armaanhammer/411-practicum/README.md

# 411-practicum
Development for ECE 411 Fall 2017 Group 16 Practicum
