armaanhammer/411-practicum/Arduino Library used/README.md

# 411-practicum
Development for ECE 411 Fall 2017 Group 16 Practicum

In order for the code for the RealTime Clock (RTC) to compile, the RTC folder must be added to your Arduino libary.
