armaanhammer/411-practicum/Project Management/BOM_UV_MONITOR_V2_1.xlsx

Qty | Value | Device | Package | Parts | Description | Price (Digikey) | subtotal
1 | ST-TF-003A | MICRO-SD-CARD-SOCKET-9P(ST-TF-003A) | MICRO-SD9+4P-SMD-16.1X14.5X1.85MM | SD1 | MicroSD Card slot | 1.02 | 1.02
1 | 32.768kHz | CRYSTAL-32.768KHZSMD-2X6 | CRYSTAL-SMD-2X6-CYL | Y1 | 32.768kHz Crystal | 0.49 | 0.49
1 | 0.1uF +/-5% | C-EUC0805 | C0805 | C4 | CAPACITOR | 0.07 | 0.07
1 | 1nF +/-5% | C-EUC0805 | C0805 | C5 | CAPACITOR | 0.07 | 0.07
8 | 2.2nF +/-5% | C-EUC0805 | C0805 | C2 | CAPACITOR | 0.09 | 0.72
1 | 470pF +/-5% | C-EUC0805 | C0805 | C1 | CAPACITOR | 0.08 | 0.08
1 | ML8511 UV_SENSOR | ML8511 | ML8511 | U4 | Lapis ML8511 Ultraviolet Sensor | 6.76 | 6.76
1 | RGB_LED | LED-RGB-CASMD | LED-TRICOLOR-SMD | D1 | LED-RGB Diffused Common Anode | 0.34 | 0.34
1 | CR-AA | CR-AA | CRAA | 3V7_LI_BATT | LI BATTERY Varta | 5.95 | 5.95
1 | CR2032H | CR2032H | CR2032H | BATTERY | LI BATTERY Varta | 0.29 | 0.29
1 | 100k | R-US_R0805 | R0805 | R5 | RESISTOR | 0.02 | 0.02
4 | 10k | R-US_R0805 | R0805 | R1 | RESISTOR | 0.02 | 0.08
1 | 150k | R-US_R0805 | R0805 | R6 | RESISTOR | 0.02 | 0.02
1 | 2k | R-US_R0805 | R0805 | R4 | RESISTOR | 0.02 | 0.02
2 | 3k | R-US_R0805 | R0805 | R7 | RESISTOR | 0.02 | 0.04
1 | 80k | R-US_R0805 | R0805 | R3 | RESISTOR | 0.02 | 0.02
1 | MIC5219 3.3V | V_REG_MIC52193.3V | SOT23-5 | U9 | V_REG MIC5219 | 0.93 | 0.93
1 | 1V | DIODE-ZENER-BZT52C3V6S | SOD-323 | D2 | Zener Diode | 0.37 | 0.37
1 | ESP8266EX | ESP8266EX | ESP8266EX | U1 | Microproc | 1.75 | 1.75
1 | LM2903M | LM2903M | M08A | U2 | Opamp comp | 0.37 | 0.37
1 | MCP7940N-I/SN | MCP7940N-I/SN | SOIC8-N_MC | U3 | Real time clock | 0.78 | 0.78
1 | batt holder |  |  |  | Coin cell Holder and contact | 0.77 | 0.77
2 | batt holder |  |  |  | AA holder | 0.39 | 0.78
 |  |  |  |  |  |  | 21.74 | Total/board
