armaanhammer/411-practicum/Eagle/Schematics and Boards/UV_MONITOR_V3_0_board_bottom.pdf

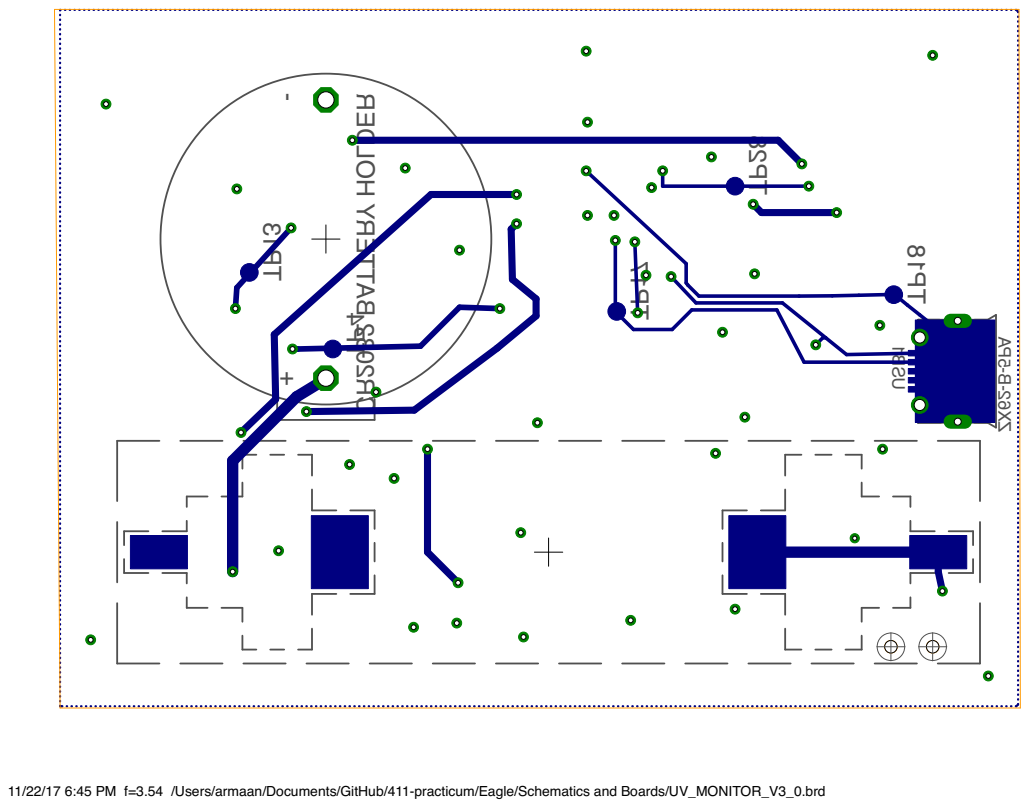
[picture p2: page 1]

11/22/17 6:45 PM f=3.54 /Users/armaan/Documents/GitHub/411-practicum/Eagle/Schematics and Boards/UV_MONITOR_V3_0.brd
