armaanhammer/411-practicum/Eagle/Schematics and Boards/UV_MONITOR_V3_0_board_top.pdf

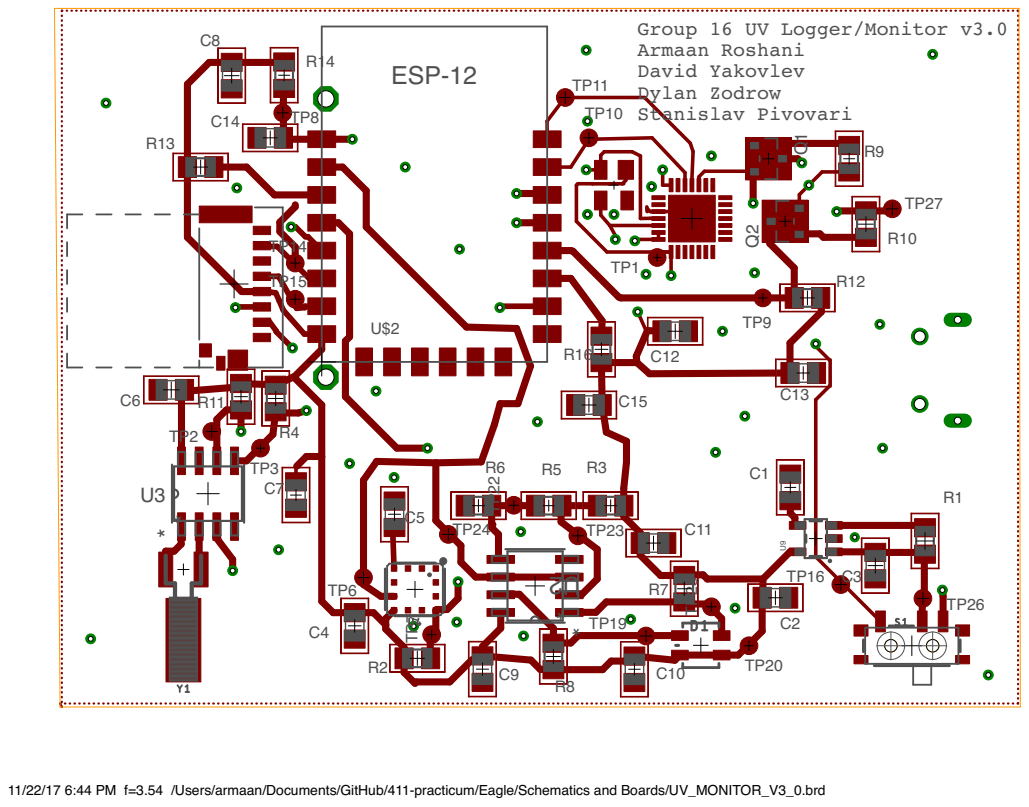
[picture p3: page 1]

Group 16 UV Logger/Monitor v3.0
Armaan Roshani
David Yakovlev
Dylan Zodrow
Stanislav Pivovari

11/22/17 6:44 PM f=3.54 /Users/armaan/Documents/GitHub/411-practicum/Eagle/Schematics and Boards/UV_MONITOR_V3_0.brd
