armaanhammer/411-practicum/Eagle/Schematics and Boards/UV_MONITOR_V3_0_schematic.pdf

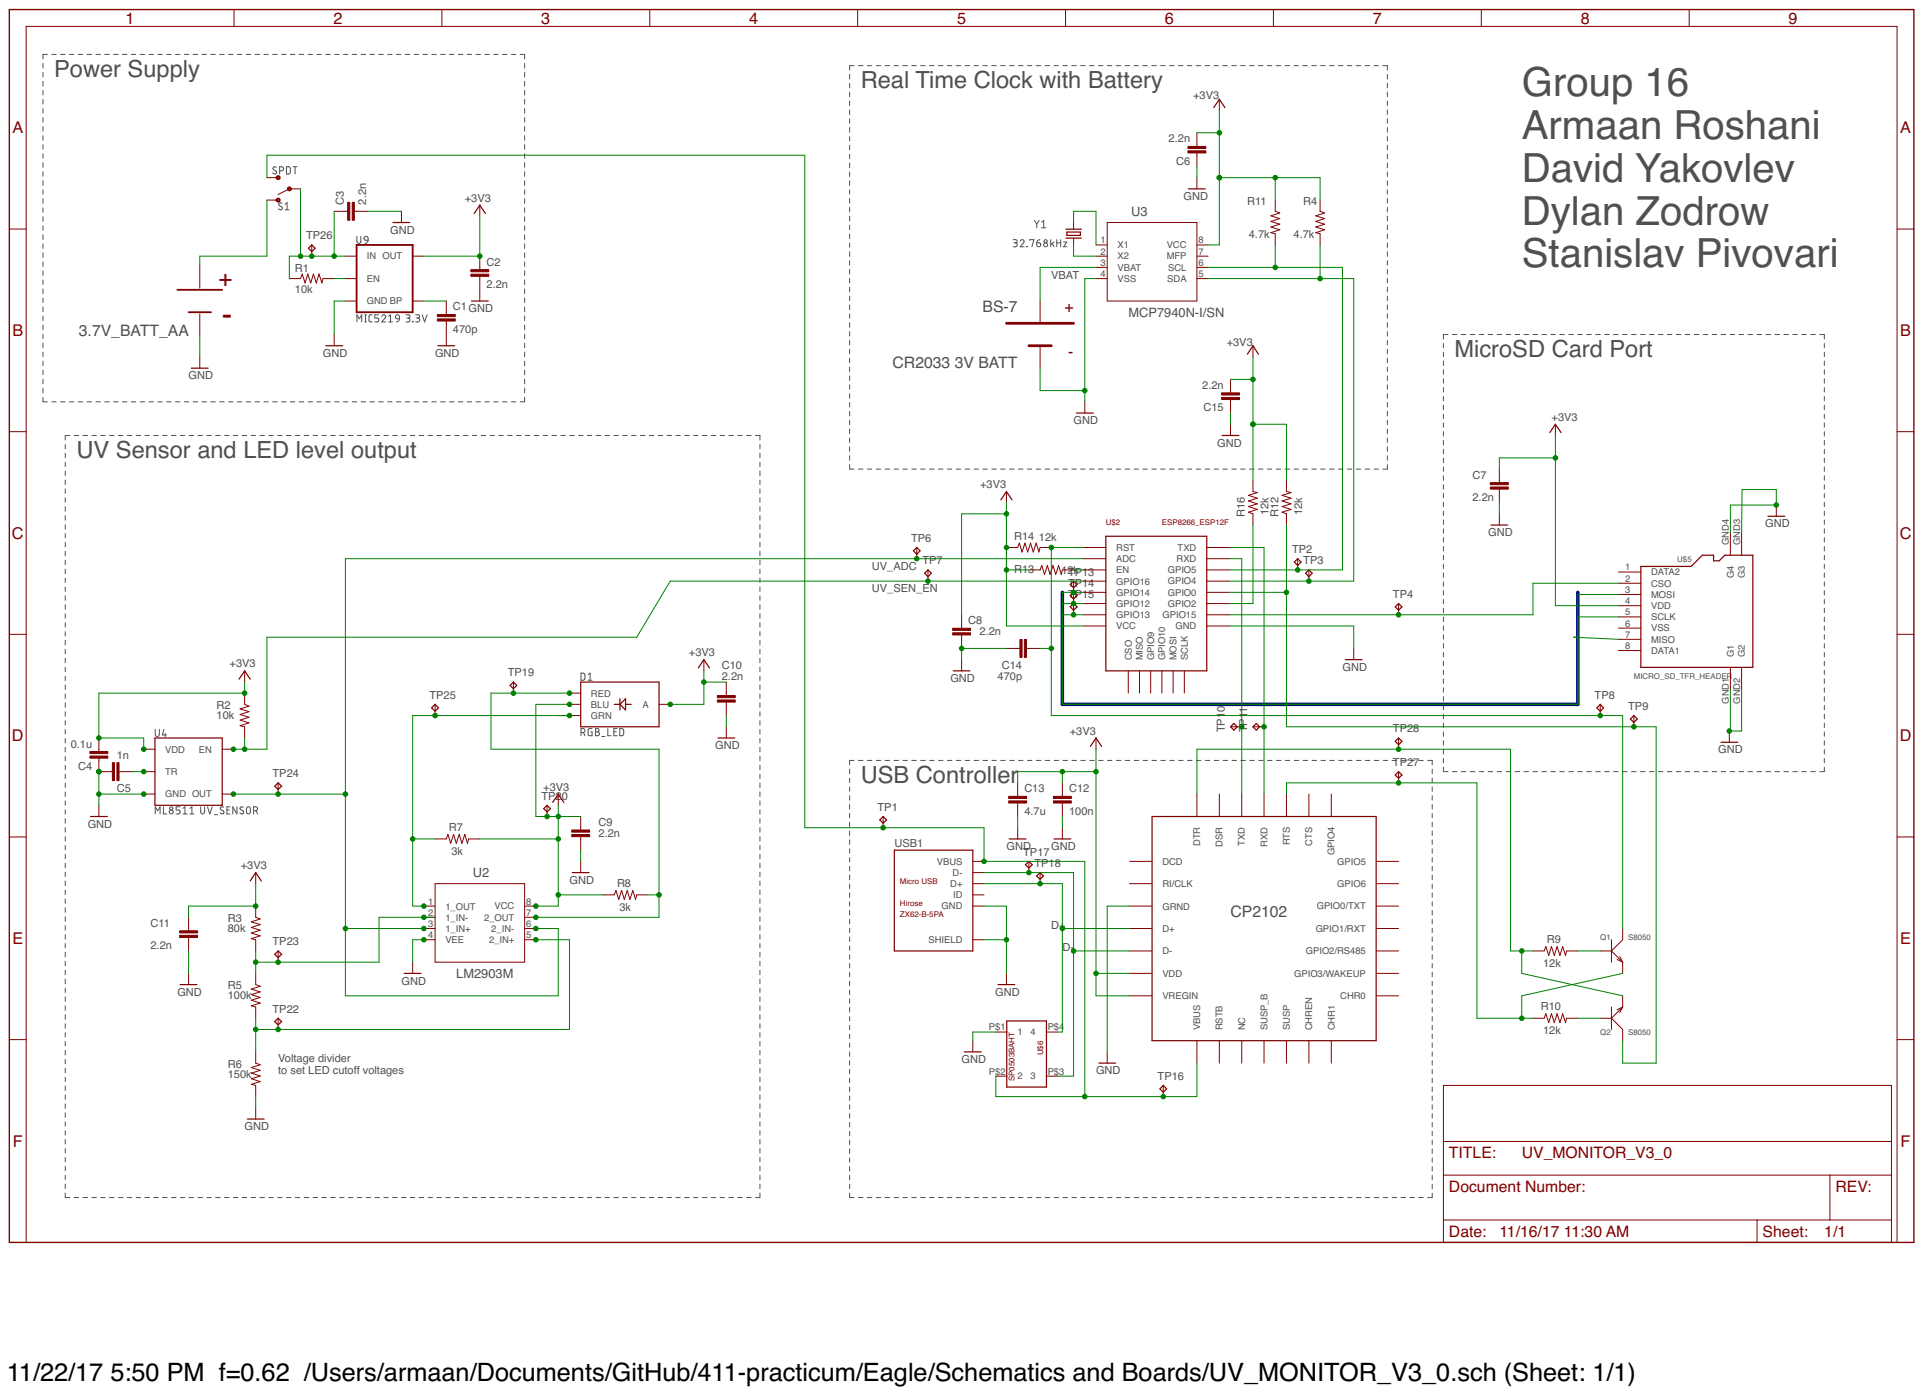
[picture p4: page 1]

UV Sensor and LED level output

CHR1 CHR0 GPIO3/WAKEUP GPIO2/RS485 GPIO1/RXT GPIO0/TXT GPIO6 GPIO5 GPIO4 CTS RTS RXD

Voltage divider
to set LED cutoff voltages

11/22/17 5:50 PM f=0.62 /Users/armaan/Documents/GitHub/411-practicum/Eagle/Schematics and Boards/UV_MONITOR_V3_0.sch (Sheet: 1/1)
