armaanhammer/411-practicum/Eagle/Schematics and Boards/UV_MONITOR_V2_5.brd

## EAGLE design Eagle/Schematics and Boards/UV_MONITOR_V2_5.brd (2017-11-22, an earlier design)

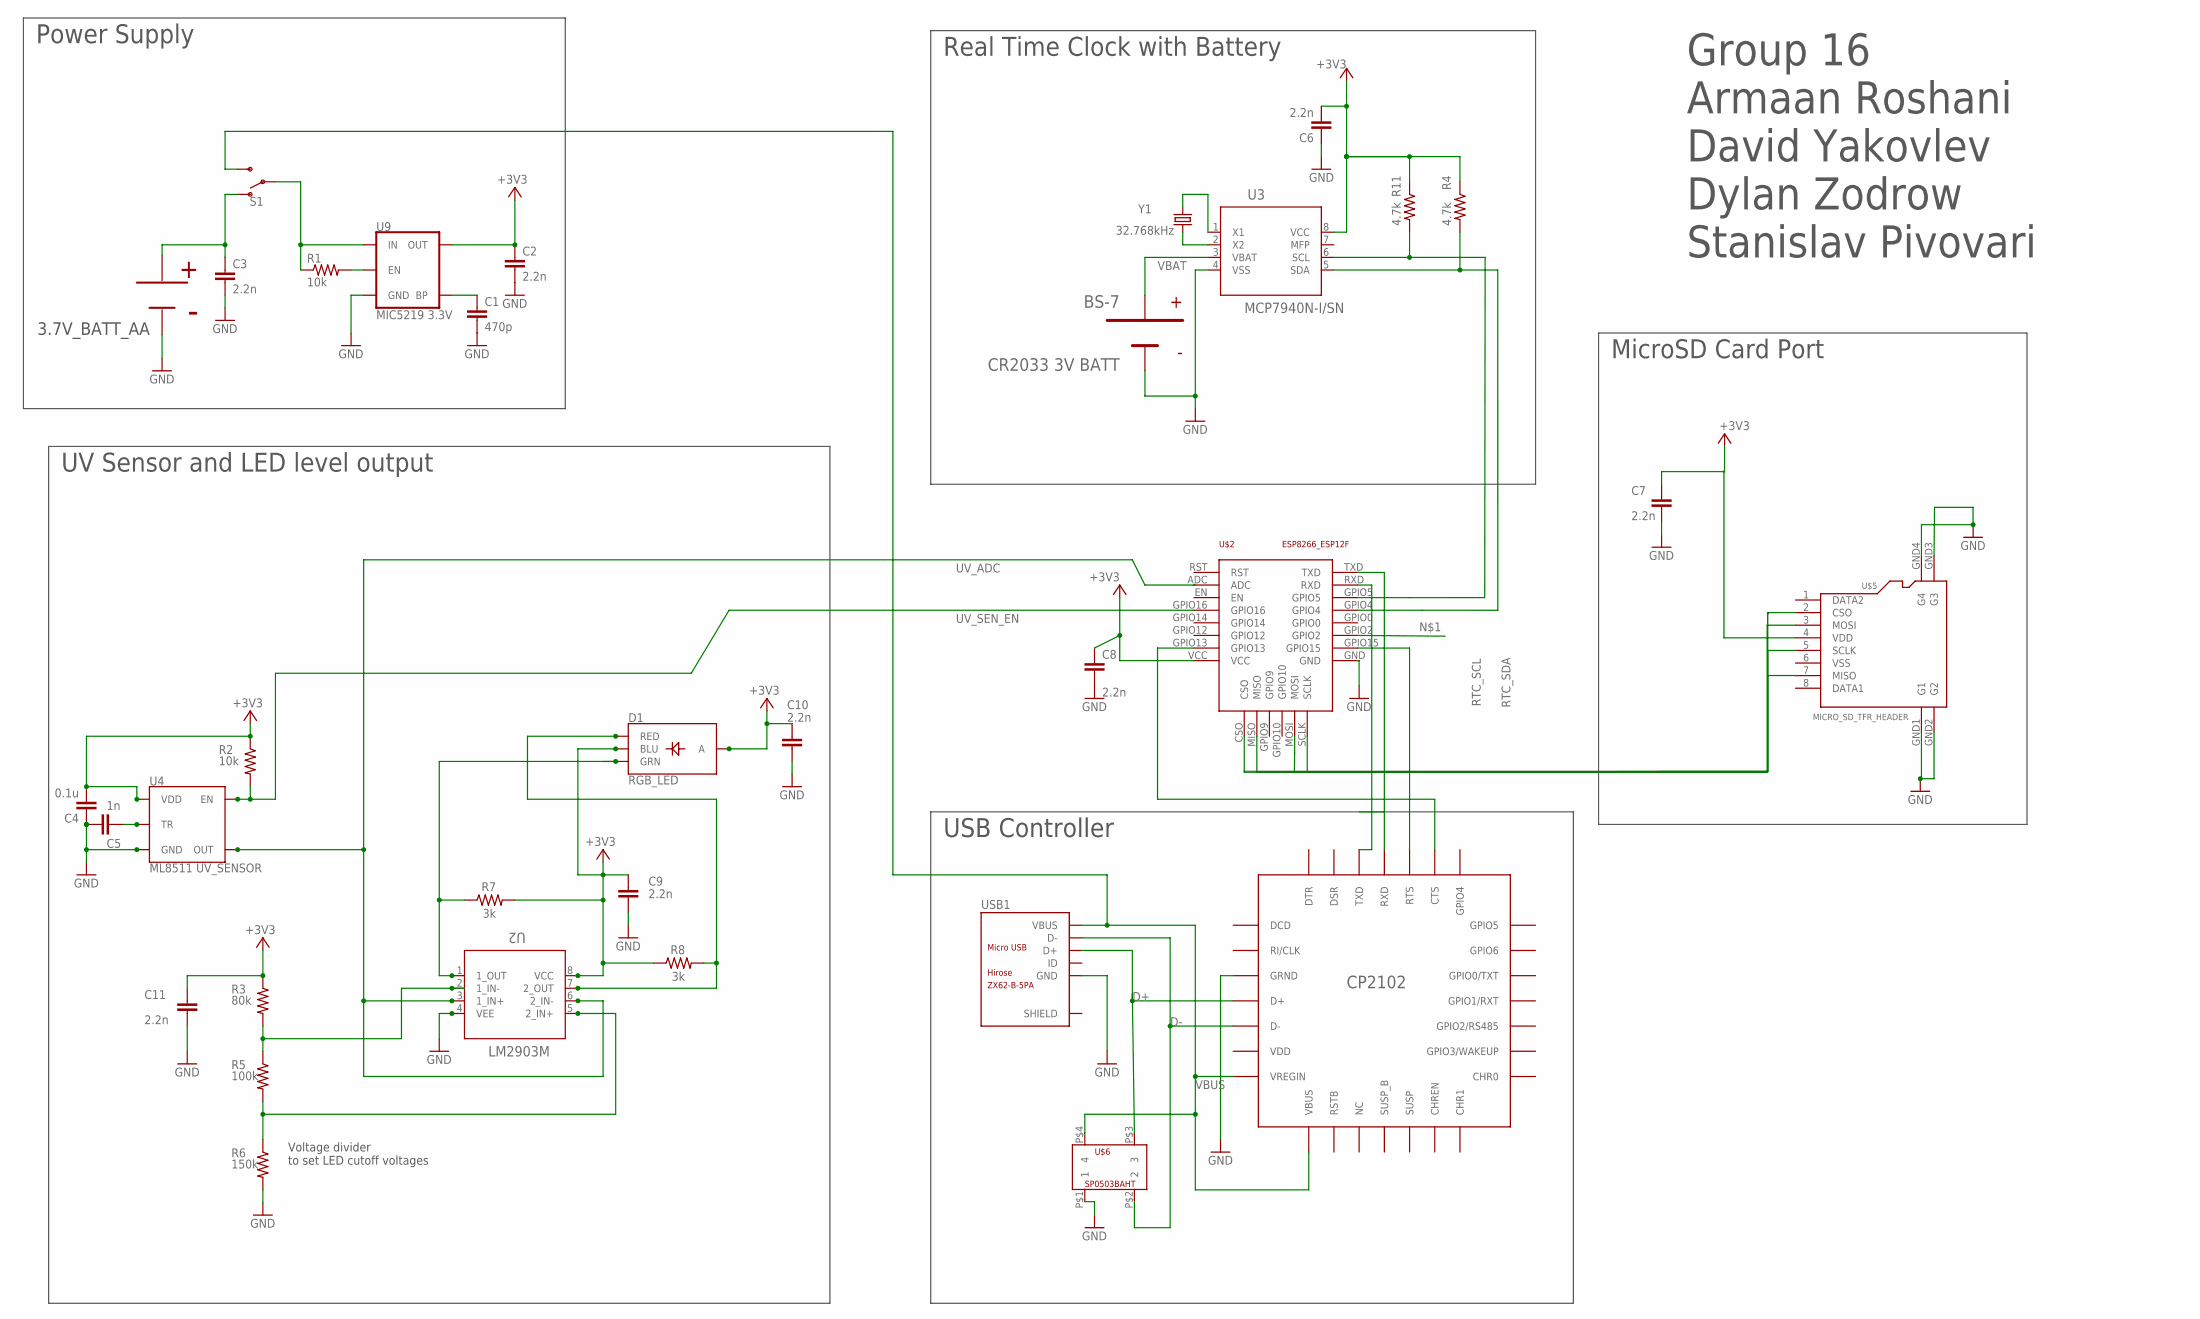
[picture p8: schematic UV_MONITOR_V2_5.sch]

Parts:
C1: 470p; C0805
C2, C3, C6, C7, C8, C9, C10, C11: 2.2n; C0805
C4: 0.1u; C0805
C5: 1n; C0805
D1: RGB_LED; LED-TRICOLOR-SMD
R1, R2: 10k; R0805
R3: 80k; R0805
R4, R11: 4.7k; R0805
R5: 100k; R0805
R6: 150k; R0805
R7, R8: 3k; R0805
S1: SWITCH-SPDT-SMD-RIGHT-ANGLE; SWITCH_SPST_SMD_A
U2: LM2903M; M08A
U3: MCP7940N-I/SN; SOIC8-N_MC
U4: ML8511 UV_SENSOR; ML8511
U9: MIC5219 3.3V; SOT23-5
U$1: CP2102
U$2: ESP12F
U$3: BK-53
U$4: BS-7
U$5: MICRO_SD_TFR_HEADER
U$6: SP0503BAHT
USB1: ZX62-B-5PA; MICRO-USB5+6P-SMD-0.65-AB
Y1: 32.768kHz; CRYSTAL-SMD-2X6-CYL

Connections:
+3V3: C2.1, C4.2, C6.2, C7.1, C8.1, C9.1, C10.1, C11.1, D1.A, D1.B (BLU), R2.1, R3.1, R4.1, R7.2, R8.1, R11.1, U2.8 (VCC), U3.8 (VCC), U4.7 (VDD), U9.5 (OUT), U$2.VCC
BP: C1.1, U9.4 (BP)
CTS: U$1.CTS, U$2.GPIO13
D+: U$1.D+, U$6.P$3 (3), USB1.3 (D+)
D-: U$1.D-, U$6.P$2 (2), USB1.2 (D-)
EN: R1.2, U9.3 (EN)
GND: C1.2, C2.2, C3.2, C4.1, C5.2, C6.1, C7.2, C8.2, C9.2, C10.2, C11.2, R6.2, U2.4 (VEE), U3.4 (VSS), U4.5 (GND), U9.2 (GND), U$1.GND (GRND), U$1.GRND, U$2.GND, U$3.GND1, U$3.GND2, U$4.GND, U$5.GND1 (G1), U$5.GND2 (G2), U$5.GND3 (G3), U$5.GND4 (G4), U$6.P$1 (1), USB1.5 (GND)
GREEN_LED: D1.G (GRN), R7.1, U2.1 (1_OUT)
H_REF: R3.2, R5.1, U2.2 (1_IN-)
L_REF: R5.2, R6.1, U2.5 (2_IN+)
MAIN_BAT: R1.1, S1.2, U9.1 (IN)
unnamed: U3.2 (X2), Y1.X1 (1)
unnamed: U$2.SCLK, U$5.5 (SCLK)
unnamed: U$2.MOSI, U$5.3 (MOSI)
unnamed: U$2.MISO, U$5.7 (MISO)
unnamed: U3.1 (X1), Y1.X2 (2)
unnamed: U$2.CSO, U$5.2 (CSO)
unnamed: U$1.RXD, U$2.TXD
unnamed: U$1.TXD, U$2.RXD
unnamed: C3.1, S1.1 (O), U$3.VBAT1 (VBAT), U$3.VBAT2 (VBAT)
RED_LED: D1.R (RED), R8.2, U2.7 (2_OUT)
RTC_SCL: R11.2, U3.6 (SCL), U$2.GPIO5
RTC_SDA: R4.2, U3.5 (SDA), U$2.GPIO4
RTS: U$1.RTS, U$2.GPIO15
TR: C5.1, U4.10 (TR)
UV_ADC: U2.3 (1_IN+), U2.6 (2_IN-), U4.8 (OUT), U$2.ADC
UV_SEN_EN: R2.2, U4.4 (EN), U$2.GPIO16
VBAT: U3.3 (VBAT), U$4.VBAT
VBUS: S1.3 (S), U$1.VBUS, U$1.VREGIN, U$6.P$4 (4), USB1.1 (VBUS)

Notes on the sheet:
Power Supply
Real Time Clock with Battery
UV Sensor and LED level output
Voltage divider to set LED cutoff voltages
Group 16 Armaan Roshani David Yakovlev Dylan Zodrow Stanislav Pivovari
USB Controller
MicroSD Card Port

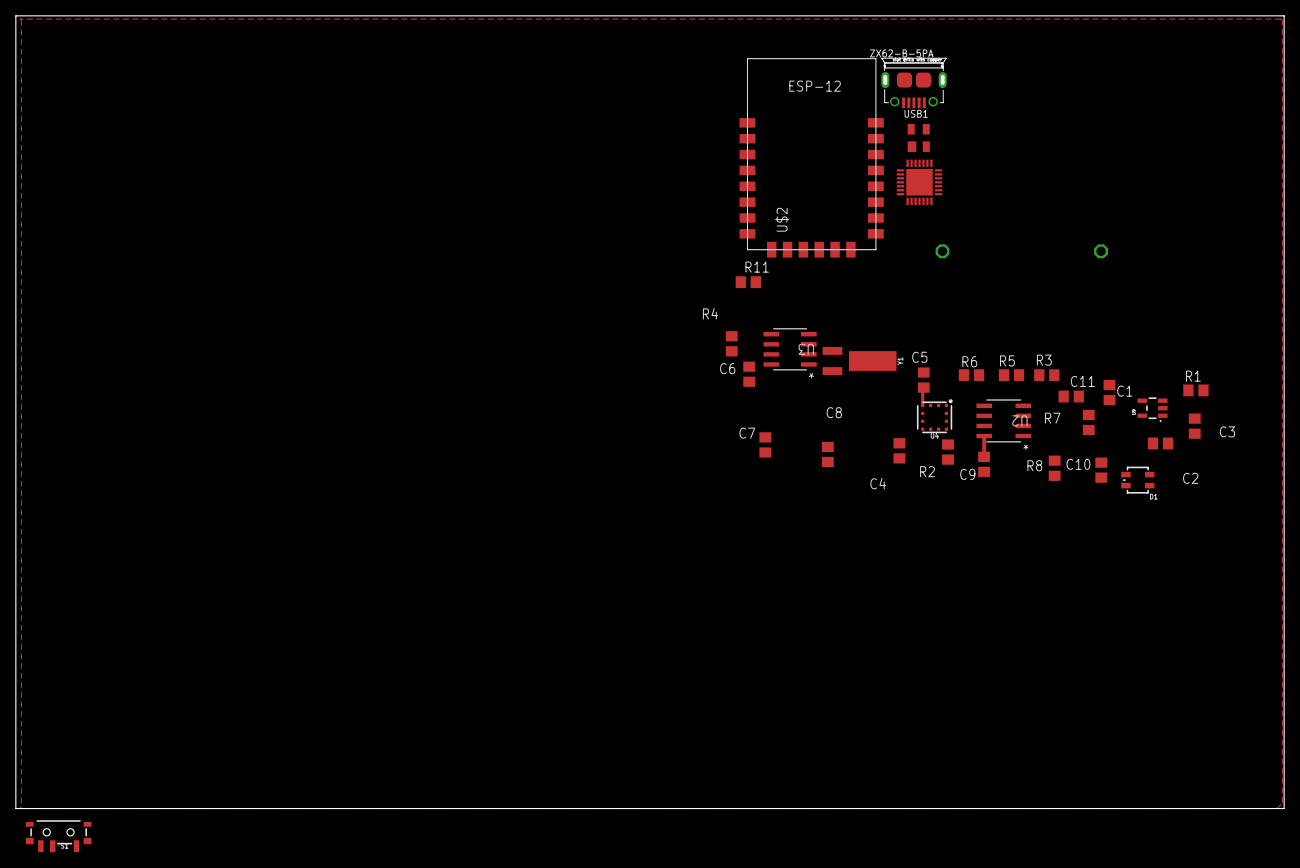
[picture p9: board UV_MONITOR_V2_5.brd from above]

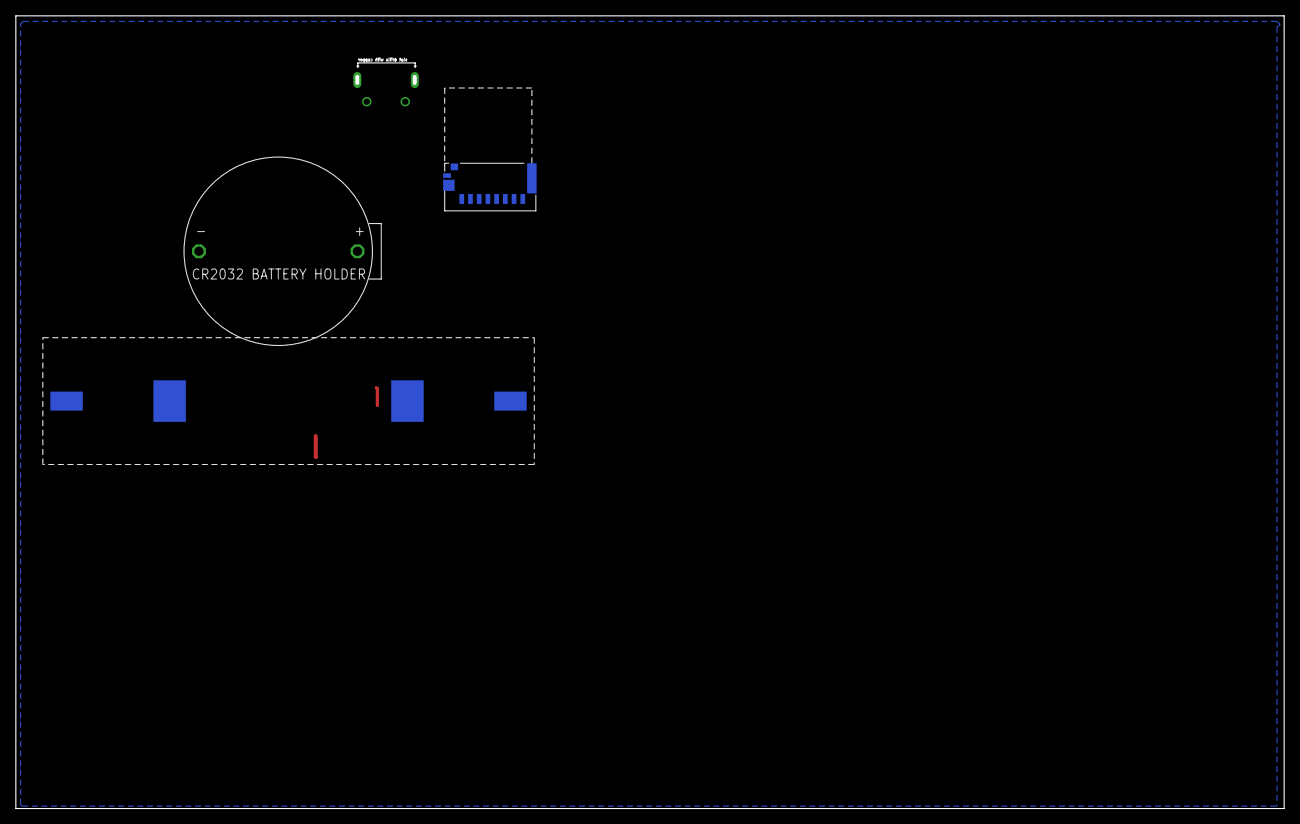
[picture p10: board UV_MONITOR_V2_5.brd from below]

Board: 2 copper layers, 160.0 x 100.0 mm, 34 parts (3 on the bottom side), 29 nets.
