armaanhammer/411-practicum/Eagle/Schematics and Boards/UV_MONITOR_V2_4.brd

## EAGLE design Eagle/Schematics and Boards/UV_MONITOR_V2_4.brd (2017-11-12, an earlier design)

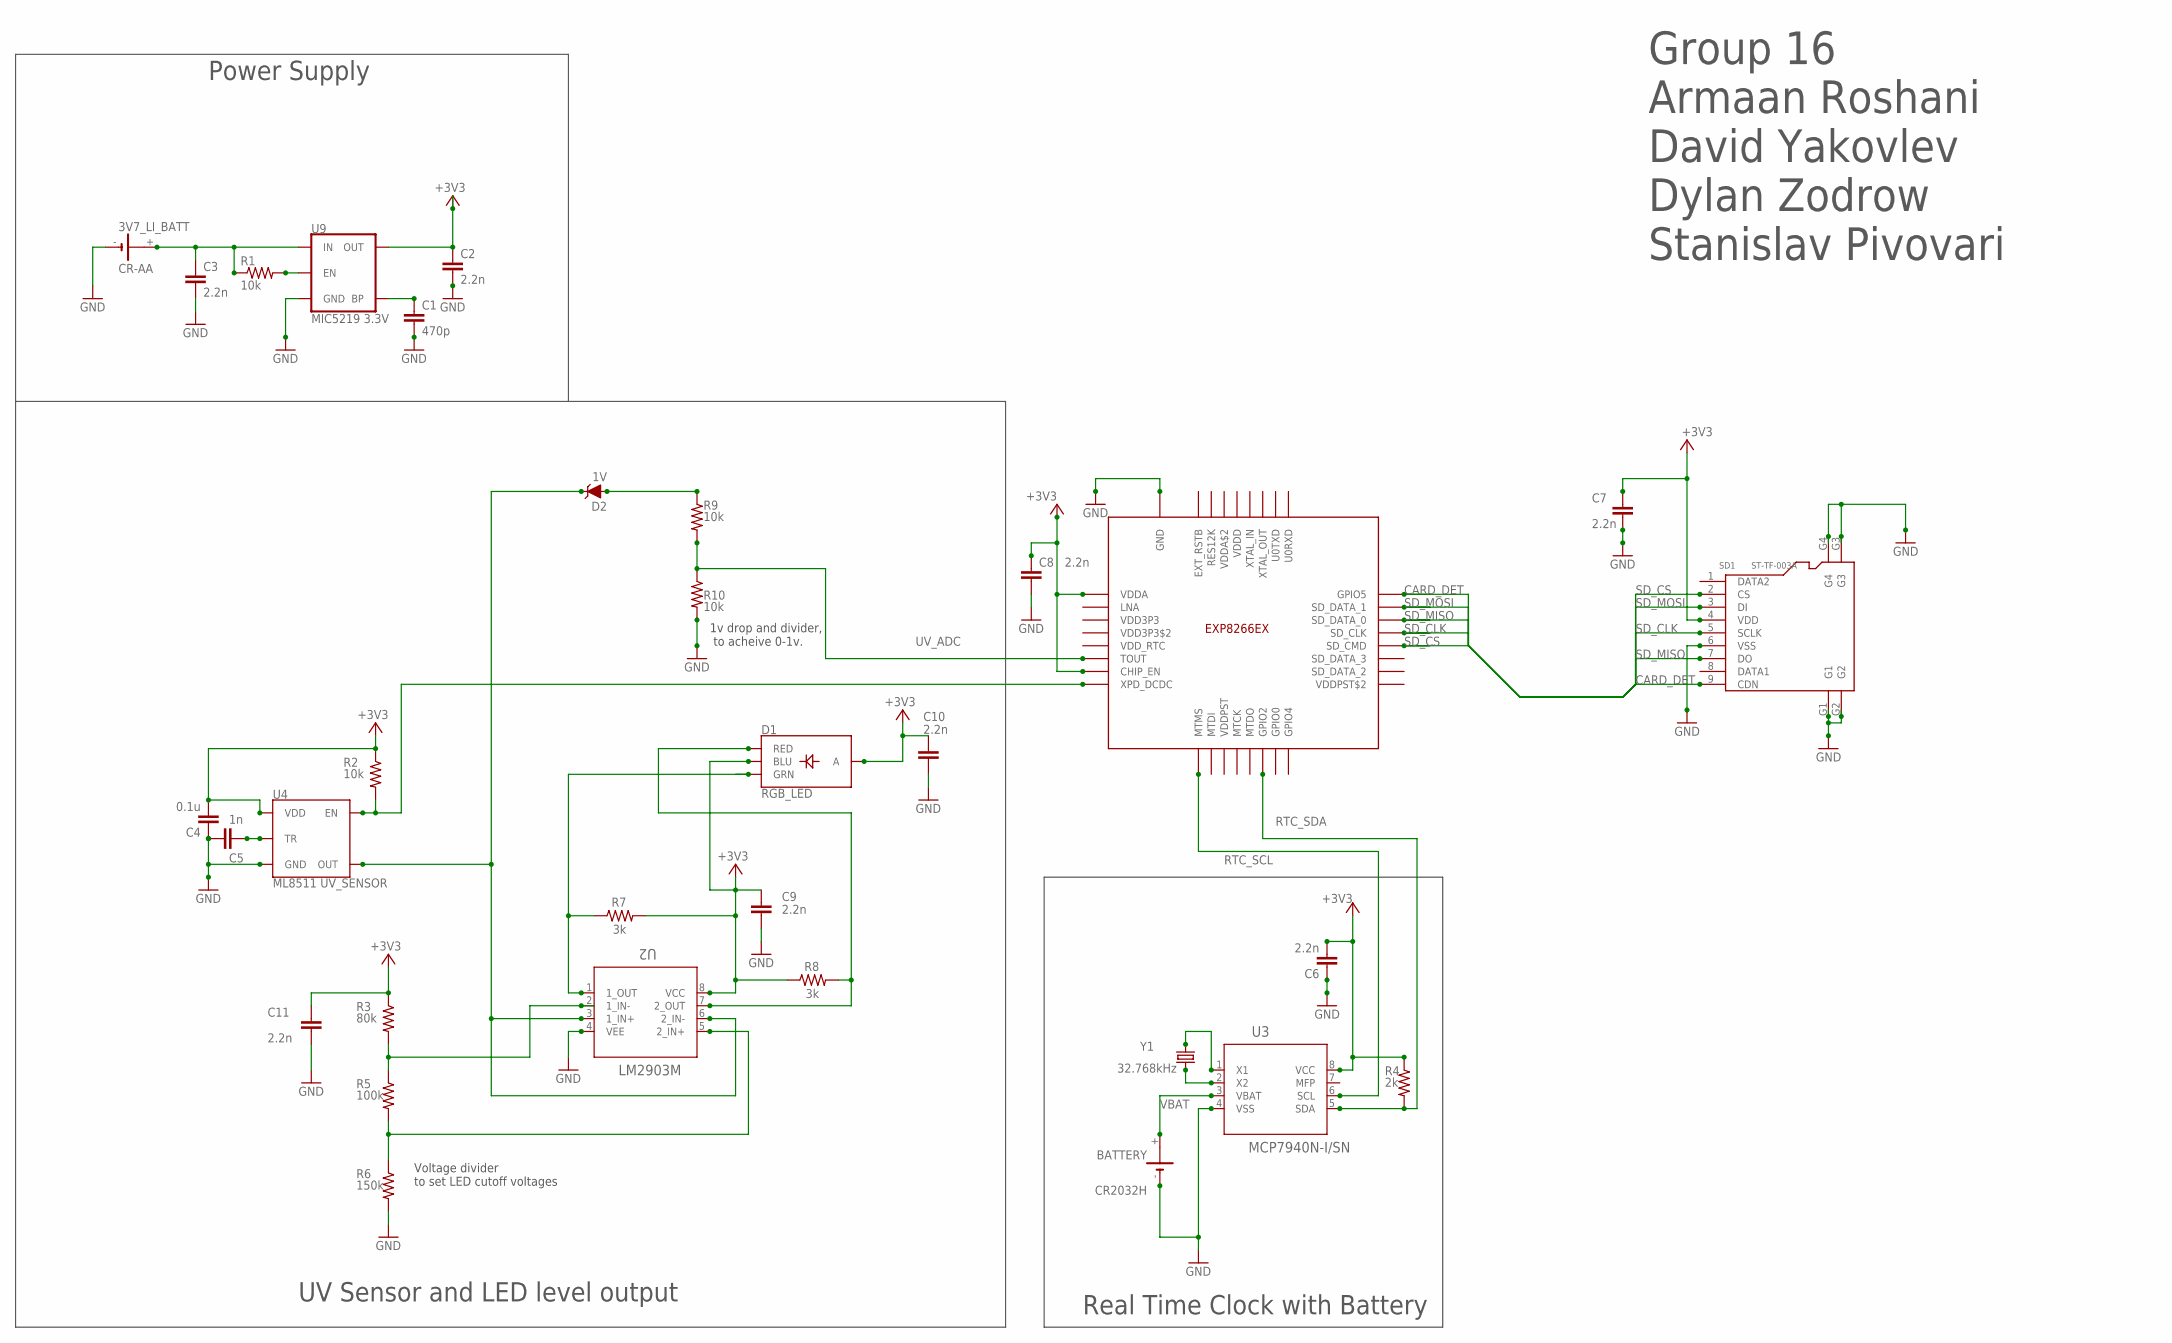
[picture p11: schematic UV_MONITOR_V2_4.sch]

Parts:
3V7_LI_BATT: CR-AA; CRAA
BATTERY: CR2032H
C1: 470p; C0805
C2, C3, C6, C7, C8, C9, C10, C11: 2.2n; C0805
C4: 0.1u; C0805
C5: 1n; C0805
D1: RGB_LED; LED-TRICOLOR-SMD
D2: 1V; SOD-323
R1, R2, R9, R10: 10k; R0805
R3: 80k; R0805
R4: 2k; R0805
R5: 100k; R0805
R6: 150k; R0805
R7, R8: 3k; R0805
SD1: ST-TF-003A; MICRO-SD9+4P-SMD-16.1X14.5X1.85MM
U1: ESP8266EX
U2: LM2903M; M08A
U3: MCP7940N-I/SN; SOIC8-N_MC
U4: ML8511 UV_SENSOR; ML8511
U9: MIC5219 3.3V; SOT23-5
Y1: 32.768kHz; CRYSTAL-SMD-2X6-CYL

Connections:
+3V3: C2.1, C4.2, C6.2, C7.1, C8.1, C9.1, C10.1, C11.1, D1.A, D1.B (BLU), R2.1, R3.1, R4.1, R7.2, R8.1, SD1.4 (VDD), U1.CHIP_EN, U1.VDDA, U2.8 (VCC), U3.8 (VCC), U4.7 (VDD), U9.5 (OUT)
BP: C1.1, U9.4 (BP)
CARD_DET: SD1.9 (CDN), U1.GPOIO5 (GPIO5)
EN: R1.2, U9.3 (EN)
GND: 3V7_LI_BATT.-, BATTERY.-, C1.2, C2.2, C3.2, C4.1, C5.2, C6.1, C7.2, C8.2, C9.2, C10.2, C11.2, R6.2, R10.2, SD1.6 (VSS), SD1.G1, SD1.G2, SD1.G3, SD1.G4, U1.GND, U2.4 (VEE), U3.4 (VSS), U4.5 (GND), U9.2 (GND)
GREEN_LED: D1.G (GRN), R7.1, U2.1 (1_OUT)
H_REF: R3.2, R5.1, U2.2 (1_IN-)
L_REF: R5.2, R6.1, U2.5 (2_IN+)
MAIN_BAT: 3V7_LI_BATT.+, C3.1, R1.1, U9.1 (IN)
unnamed: U3.2 (X2), Y1.X1 (1)
unnamed: U3.1 (X1), Y1.X2 (2)
RED_LED: D1.R (RED), R8.2, U2.7 (2_OUT)
RTC_SCL: U1.MTMS, U3.6 (SCL)
RTC_SDA: R4.2, U1.GPIO2, U3.5 (SDA)
SD_CLK: SD1.5 (SCLK), U1.SD_CLK
SD_CS: SD1.2 (CS), U1.SD_CMD
SD_MISO: SD1.7 (DO), U1.SD_DATA_0
SD_MOSI: SD1.3 (DI), U1.SD_DATA_1
TR: C5.1, U4.10 (TR)
UV_ADC: R9.2, R10.1, U1.TOUT
UV_ADC_1: D2.A, R9.1
UV_ADC_2: D2.C, U2.3 (1_IN+), U2.6 (2_IN-), U4.8 (OUT)
UV_SEN_EN: R2.2, U1.XPD_DCDC, U4.4 (EN)
VBAT: BATTERY.+, U3.3 (VBAT)

Notes on the sheet:
Power Supply
Real Time Clock with Battery
UV Sensor and LED level output
1v drop and divider, to acheive 0-1v.
Voltage divider to set LED cutoff voltages
Group 16 Armaan Roshani David Yakovlev Dylan Zodrow Stanislav Pivovari

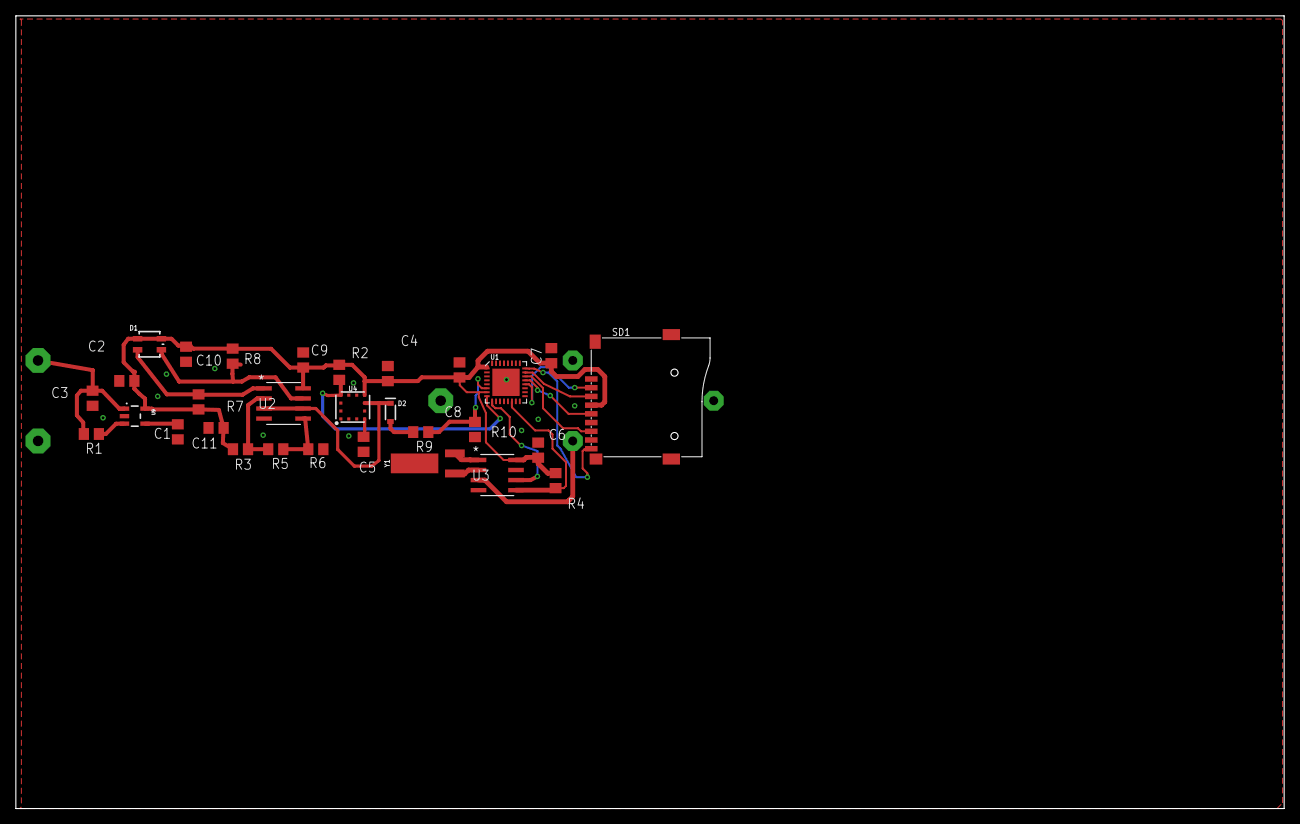
[picture p12: board UV_MONITOR_V2_4.brd from above]

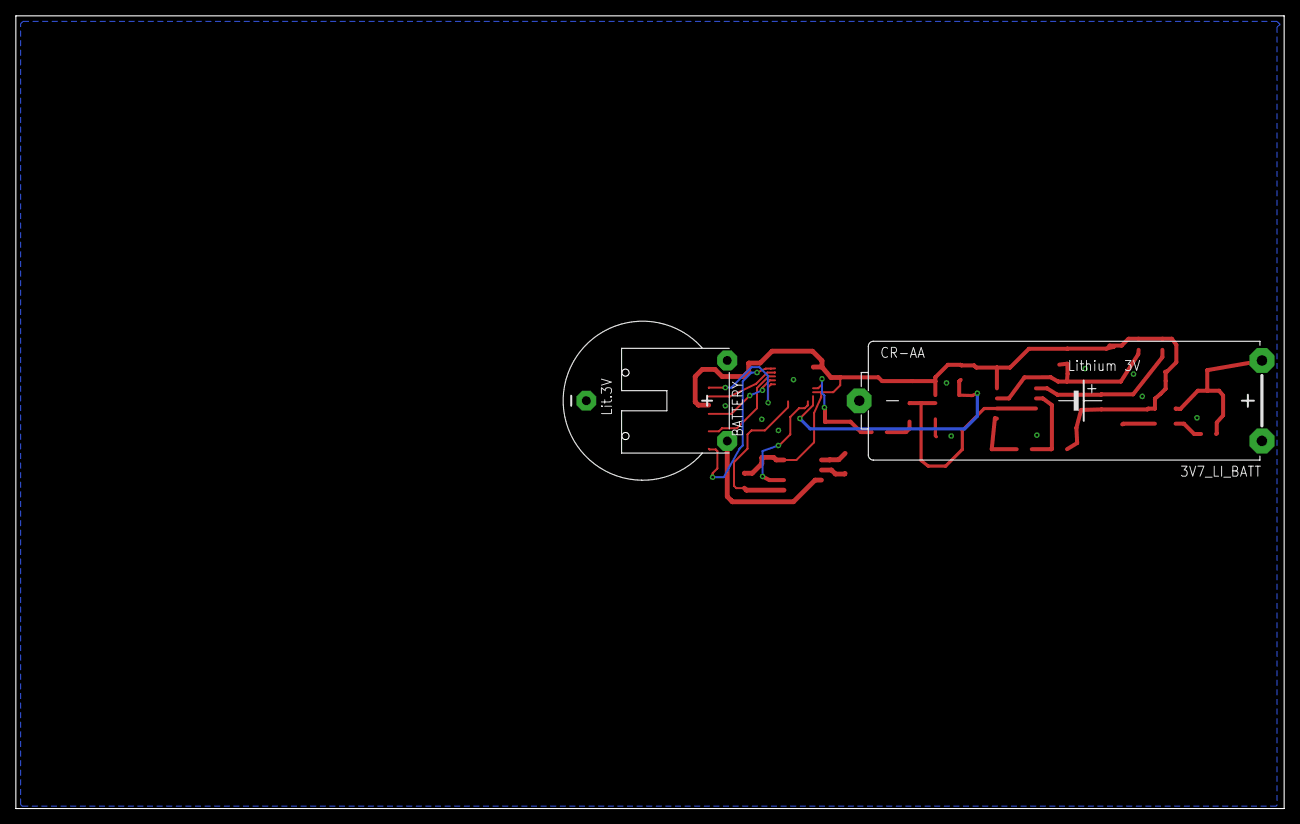
[picture p13: board UV_MONITOR_V2_4.brd from below]

Board: 2 copper layers, 160.0 x 100.0 mm, 32 parts (2 on the bottom side), 24 nets.
