armaanhammer/411-practicum/Software/scratch/UVReadings/UVReadings.ino

void setup() {
  // initialize serial communication at 9600 bits per second:
  Serial.begin(115200);
}

// the loop routine runs over and over again forever:
void loop() {
  // read the input on analog pin 0:
  int sensorValue = analogRead(A0);
  // Convert the analog reading (which goes from 0 - 1023) to a voltage (0 - 5V):
  float voltage = sensorValue * (5.0 / 1023.0);
  // print out the value you read:
  Serial.print("\nAnalog value: \t");
  Serial.print(sensorValue);
  Serial.print("\tVoltage: \t");
  Serial.print(voltage);

  delay(1000); //wait for 1 second
}
