armaanhammer/411-practicum/(commit log)

2017-10-26 Add files via upload
    Ver.1 preliminary project schematic
    [UV_MONITOR.sch]
2017-11-02 Add files via upload
    Forgot to put group # and names on previous
    [UV_MONITOR_V2.1.sch]
2017-11-12 SDcard sketch debuggin
    Added a text file explaining current issues, and made minor edits to .ino files.
    [RTC.ino, SDcard.ino]
2017-11-14 All three devices now working.
    RTC, UV sensor, and SD Card are now working. Created a sketch called all_three.ino to test everything. It first dumps all data already in file datalog.txt and then adds a line once per second. It uses the RTC and UV sensor to generate data for each line.
2017-11-15 updated UV Index approximation and added set_RTC
    set_RTC.ino sets the time on the RTC and does nothing else. all_three.ino no longer sets the time, but does everything else. Also, UV Index is normalized and recalculated to closer approximate a reasonable value.
    [set_RTC.ino]
2017-11-22 minor edits
    Created some edits for my own benefit. These edits were to an old version of our schematic and board.
    [UV_MONITOR_V2_5.brd, UV_MONITOR_V2_5.sch]
2017-11-22 Organizing
    Moved around and renamed a lot of items. Most important change is all_three.ino has been renamed to UV_logger.ino
    [BOM_UV_MONITOR_V2_1.xlsx, UV_MONITOR.sch, UV_MONITOR_V2.1.sch, UV_MONITOR_V2.sch, UV_MONITOR_V2_1.brd, UV_MONITOR_V2_4.brd, UV_MONITOR_V2_4.sch, UV_MONITOR_V2_5.brd]
2017-11-23 created board and schematic archive
    moved stuff
    [UV_MONITOR.sch, UV_MONITOR_V2.1.sch, UV_MONITOR_V2.sch, UV_MONITOR_V2_1.brd, UV_MONITOR_V2_4.brd, UV_MONITOR_V2_4.sch, UV_MONITOR_V2_5.brd, UV_MONITOR_V2_5.sch]
2017-11-23 editing polygon layers, adding PDFs
    [UV_MONITOR_V3_0.brd]
